DJAndries/picodo/docs/schematic/schematic.sch

## KiCad design docs/schematic/schematic.sch (2020-10-10)

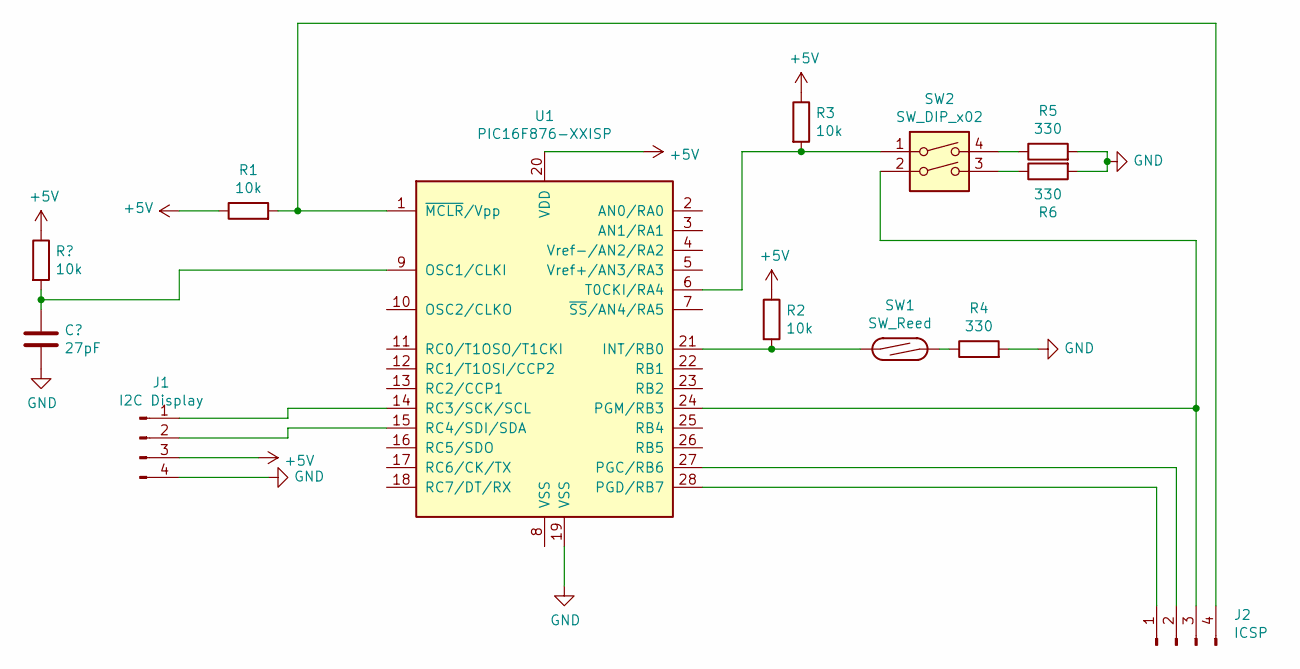
[picture p2: schematic schematic.sch]

Parts:
J1: I2C Display
J2: ICSP
R1, R2, R3: 10k
R4, R5, R6: 330
SW1: SW_Reed
SW2: SW_DIP_x02
U1: PIC16F876-XXISP

Connections:
+5V: J1.3, R1.1, R2.1, R3.1, U1.20 (VDD)
GND: J1.4, R4.2, R5.2, R6.2, U1.19 (VSS)
unnamed: J1.1, U1.14 (RC3/SCK/SCL)
unnamed: J1.2, U1.15 (RC4/SDI/SDA)
unnamed: J2.1, U1.28 (PGD/RB7)
unnamed: J2.2, U1.27 (PGC/RB6)
unnamed: J2.3, SW2.2, U1.24 (PGM/RB3)
unnamed: J2.4, R1.2, U1.1 (~MCLR~/Vpp)
unnamed: R2.2, SW1.1, U1.21 (INT/RB0)
unnamed: R3.2, SW2.1, U1.6 (T0CKI/RA4)
unnamed: R4.1, SW1.2
unnamed: R5.1, SW2.4
unnamed: R6.1, SW2.3
